girst/chiptunes-mirror-of-git.gir.st/pcb/chiptunes-flex/chiptunes-flex.kicad_pcb

## KiCad design pcb/chiptunes-flex/chiptunes-flex.kicad_pcb (2020-07-27)

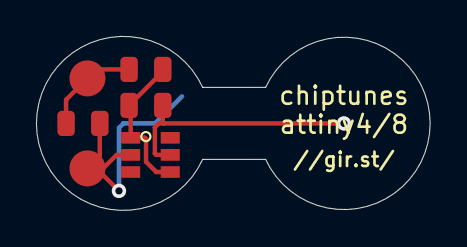
[picture p1: board chiptunes-flex.kicad_pcb from above]

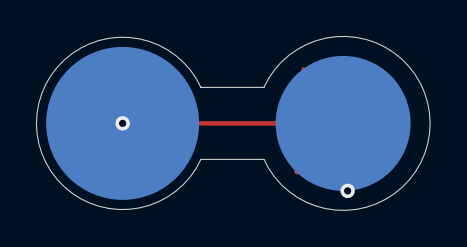
[picture p2: board chiptunes-flex.kicad_pcb from below]

Board: 2 copper layers, 21.9 x 9.7 mm, 8 parts (2 on the bottom side), 4 nets.

Parts:
C1: 100n; C_0805_2012Metric
R1: 100k; R_0805_2012Metric
R2: 200; R_0805_2012Metric
TP1: bat+; TestPoint_Pad_D2.0mm
TP2: bat-; TestPoint_Pad_D2.0mm
TP3: audio+; TestPoint_Pad_D2.0mm
TP4: audio-; TestPoint_Pad_D2.0mm
U1: ATtiny4-TS; SOT-23-6

Connections:
+3V0: R1.1, TP1.1, U1.5
GND: C1.2, TP2.1, TP4.1, U1.2
unnamed: C1.1, R2.1, TP3.1
unnamed: R1.2, R2.2, U1.1, U1.4
