girst/chiptunes-mirror-of-git.gir.st/(commit log)

2018-12-11 new version
    using this we can save a few more cycles (code size not yet compared).
    working principle:
    we can distinguish which number to multiply by with the lower nibble
    only. to have maximum overlap, use a decision tree to select where to
    go. the upper nibble is then just a straight path (there is not much
    to deduplicate).
    worst case (roughly):
    - mul-tree: 30cy tree + 5cy to load data[t]
    - cpi-breq-rjmp: 37cy mul_xx + 5cy to load data[t]
    - ldZ-ijmp: 28cy mul_xx + 10cy to load mul_jmptable[t]
2018-12-11 initialisation code, interrupt vector table
    it werks! (it's completely out of tune and too fast, but audio is coming
    out of the chip. program at 5v, then play at 3v3. chip can't handle the
    stereo amp, but headphones work)
2018-12-11 add debug pin, remove 2 unnecessary instructions
2018-12-14 fix Ml register, clear interrupt before RETI
2018-12-18 fix jitter
    yeah...don't rjmp into interrupt instead of main loop m(
2018-12-21 calibrate oscillator
    just measure frequency of PORTB2 and fiddle with the number until it's
    close enough. don't forget to hold your tongue at the right angle!
2020-03-01 fix melody for voices 3 and 4
    15 months later, I took another look at why the music was off for
    channels 3 and 4 and pretty fast noticed that it affects only the voices
    using the mod3 subroutine. Executing mod3 with simavr[1] showed that the
    compare-branch step is broken. Switching BRPL for the correct BRCS fixed
    the problem.
    [1]: in the hackiest way imaginable:
    gdb> layout regs
    gdb> set $r24 = 0x15 # test value for Mh
    gdb> set $r23 = 0x16 # test value for Ml
    gdb> set $pc = 0x1a # start of mod3 routine
    gdb> ni # repeatedly
2020-03-02 optimize multiplication for space
    AVR Memory Usage
    ----------------
    Device: attiny4
    Program: 474 bytes (92.6% Full)
    (.text + .data + .bootloader)
    Data: 0 bytes (0.0% Full)
    (.data + .bss + .noinit)
2020-03-07 first ideas regarding automatic power-off after 1 loop of playback
2020-03-07 first test of pcint0 implementation
    note: does not work, since nested interrupts are disabled by default,
    and we are not calling SEI before SLEEP. this makes the mcu never wake
    up again
2020-03-09 remove i3
    since we are now stopping after each iteration, it makes no sense to go
    beyond 7864320 samples.
2020-07-16 cleanup; switch to INT0
    working with external pullup and pb0+pb2 shorted
2020-07-25 flex PCB, version 1
    as ordered from oshpark
    [chiptunes-flex.kicad_pcb, chiptunes-flex.sch]
2020-07-27 pcb: add low pass filter
    [chiptunes-flex.kicad_pcb, chiptunes-flex.sch]
2020-10-03 check in assembly notes
